blakeh01/capstone_pl/em_powerstage/Project Lab 4.kicad_pcb

## KiCad design em_powerstage/Project Lab 4.kicad_pcb (2024-09-30)

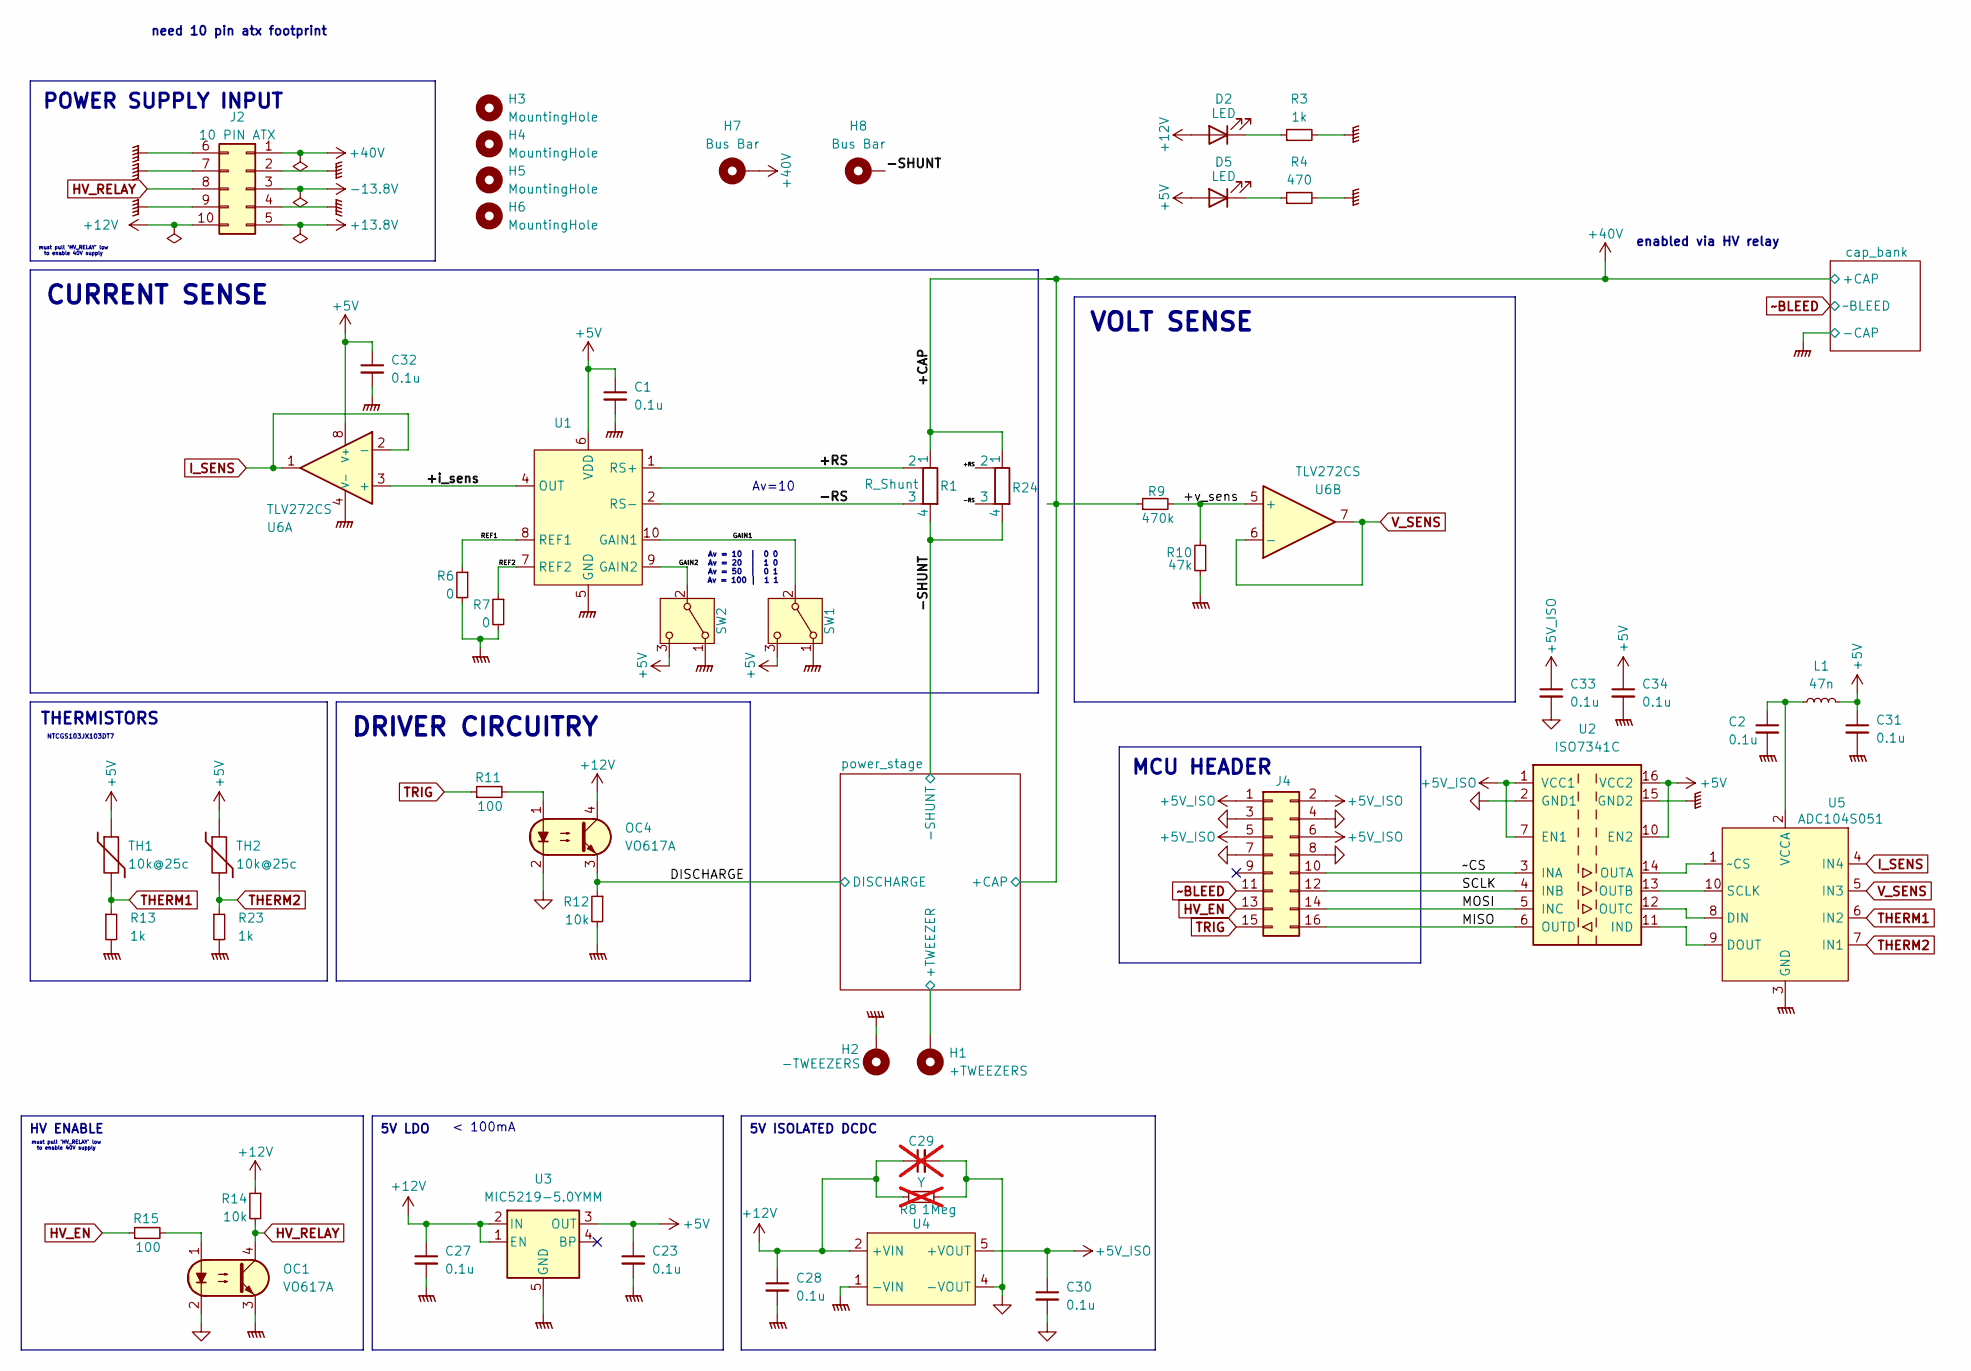
[picture p1: schematic Project Lab 4.kicad_sch]

Parts:
C1, C2, C23, C27, C28, C30, C31, C32, C33, C34: 0.1u; C_1206_3216Metric_Pad1.33x1.80mm_HandSolder
C29: Y; C_Disc_D8.0mm_W2.5mm_P5.00mm; not fitted
D2, D5: LED; LED_1206_3216Metric_Pad1.42x1.75mm_HandSolder
H1: +TWEEZERS; MountingHole_4.3mm_M4_Pad
H2: -TWEEZERS; MountingHole_4.3mm_M4_Pad
H3, H4, H5, H6: MountingHole; MountingHole_4mm
H7: Bus Bar; busbar_28mmX155mm
H8: Bus Bar; busbar_35mm_18mm
J2: 10 PIN ATX; Molex_Mini-Fit_Jr_5566-10A_2x05_P4.20mm_Vertical
J4: Conn_02x08_Odd_Even; PinHeader_2x08_P2.54mm_Vertical
L1: 47n; L_1206_3216Metric_Pad1.22x1.90mm_HandSolder
OC1, OC4: VO617A; DIP-4_W7.62mm_LongPads
R1: R_Shunt; CSS4J4026RL500F
R3, R13, R23: 1k; R_0805_2012Metric_Pad1.20x1.40mm_HandSolder
R4: 470; R_0805_2012Metric_Pad1.20x1.40mm_HandSolder
R6, R7: 0; R_0805_2012Metric_Pad1.20x1.40mm_HandSolder
R8: 1Meg; R_Axial_DIN0207_L6.3mm_D2.5mm_P15.24mm_Horizontal; not fitted
R9: 470k; R_0805_2012Metric_Pad1.20x1.40mm_HandSolder
R10: 47k; R_0805_2012Metric_Pad1.20x1.40mm_HandSolder
R11, R15: 100; R_0805_2012Metric_Pad1.20x1.40mm_HandSolder
R12, R14: 10k; R_0805_2012Metric_Pad1.20x1.40mm_HandSolder
R24: R_Shunt; CSM2F6918L050J21
SW1, SW2: SW_SPDT; SW_E-Switch_EG1271_SPDT
TH1, TH2: 10k@25c; R_0402_1005Metric_Pad0.72x0.64mm_HandSolder
U1: TDFN-10-SMD
U2: ISO7341C; SOIC-16W_7.5x10.3mm_P1.27mm
U3: MIC5219-5.0YMM; MSOP-8_3x3mm_P0.65mm
U4: 1769405241
U5: ADC104S051; MSOP-10-1EP_3x3mm_P0.5mm_EP1.73x1.98mm
U6: TLV272CS; SO-8_3.9x4.9mm_P1.27mm

Connections:
+5V: C1.1, C23.1, C31.1, C32.1, C34.1, D5.2 (A), L1.2, SW1.3 (C), SW2.3 (C), TH1.1, TH2.1, U1.6 (VDD), U2.10 (EN2), U2.16 (VCC2), U3.3 (OUT), U6.8 (V+)
+5V_ISO: C30.1, C33.1, J4.1, J4.2, J4.5, J4.6, U2.1 (VCC1), U2.7 (EN1), U4.5 (+VOUT)
+12V: C27.1, C28.1, C29.1, D2.2 (A), J2.10, OC4.4, R8.1, R14.1, U3.1 (EN), U3.2 (IN), U4.2 (+VIN); also elsewhere on the board
+13.8V: J2.5
+40V: H7.1, J2.1, R1.1, R9.1, R24.1; also elsewhere on the board
-13.8V: J2.3
/+RS: R1.2, R24.2, U1.1 (RS+)
/+i_sens: U1.4 (OUT), U6.3 (+)
/+v_sens: R9.2, R10.2, U6.5 (+)
/-RS: R1.3, R24.3, U1.2 (RS-)
/-SHUNT: H8.1, R1.4, R24.4; also elsewhere on the board
/DISCHARGE: OC4.3, R12.1; also elsewhere on the board
/GAIN1: SW1.2 (B), U1.10 (GAIN1)
/GAIN2: SW2.2 (B), U1.9 (GAIN2)
/MISO: J4.16, U2.6 (OUTD)
/MOSI: J4.14, U2.5 (INC)
/REF1: R6.1, U1.8 (REF1)
/REF2: R7.1, U1.7 (REF2)
/SCLK: J4.12, U2.4 (INB)
/power_stage/+TWEEZER: H1.1; also elsewhere on the board
/~CS: J4.10, U2.3 (INA)
GND: C29.2, C30.2, C33.2, J4.3, J4.4, J4.7, J4.8, OC1.2, OC4.2, R8.2, U2.2 (GND1), U2.8 (GND1), U4.4 (-VOUT); also elsewhere on the board
GNDPWR: C1.2, C2.2, C23.2, C27.2, C28.2, C31.2, C32.2, C34.2, H2.1, J2.2, J2.4, J2.6, J2.7, J2.9, OC1.3, R3.2, R4.2, R6.2, R7.2, R10.1, R12.2, R13.2, R23.2, SW1.1 (A), SW2.1 (A), U1.5 (GND), U2.9 (GND2), U2.15 (GND2), U3.5 (GND), U3.6 (GND), U3.7 (GND), U3.8 (GND), U4.1 (-VIN), U5.3 (GND), U6.4 (V-); also elsewhere on the board
HV_EN: J4.13, R15.1
HV_RELAY: J2.8, OC1.4, R14.2
I_SENS: U5.4 (IN4), U6.1, U6.2 (-)
unnamed: D2.1 (K), R3.1
unnamed: D5.1 (K), R4.1
unnamed: OC1.1, R15.2
unnamed: OC4.1, R11.2
unnamed: U2.11 (IND), U5.9 (DOUT)
unnamed: U2.14 (OUTA), U5.1 (~CS)
unnamed: U2.13 (OUTB), U5.10 (SCLK)
unnamed: U2.12 (OUTC), U5.8 (DIN)
unnamed: C2.1, L1.1, U5.2 (VCCA)
THERM1: R13.1, TH1.2, U5.6 (IN2)
THERM2: R23.1, TH2.2, U5.7 (IN1)
TRIG: J4.15, R11.1
V_SENS: U5.5 (IN3), U6.6 (-), U6.7
~BLEED: J4.11; also elsewhere on the board

Notes on the sheet:
POWER SUPPLY INPUT
5V ISOLATED DCDC
MCU HEADER
HV ENABLE
DRIVER CIRCUITRY
5V LDO
CURRENT SENSE
VOLT SENSE
THERMISTORS
must pull 'HV_RELAY' low to enable 40V supply
enabled via HV relay
NTCGS103JX103DT7
need 10 pin atx footprint
< 100mA
Av = 10 | 0 0 Av = 20 | 1 0 Av = 50 | 0 1 Av = 100 | 1 1
Av=10

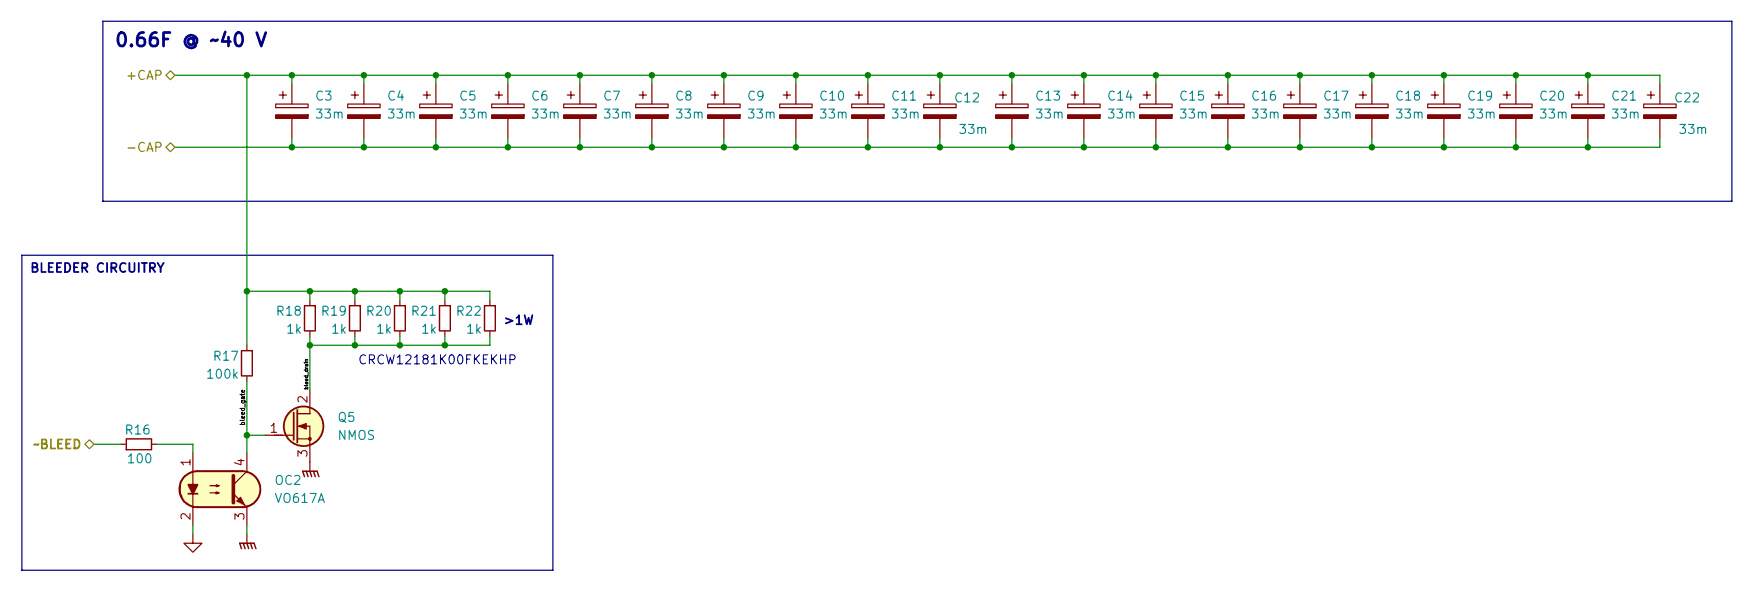
[picture p2: schematic cap_bank.kicad_sch]

Parts:
C3, C4, C5, C6, C7, C8, C9, C10, C11, C12, C13, C14, C15, C16, C17, C18, C19, C20, C21, C22: 33m; CAPPRD1000W190D3550H8200
OC2: VO617A; DIP-4_W7.62mm_LongPads
Q5: NMOS; SOT-23-3
R16: 100; R_0805_2012Metric_Pad1.20x1.40mm_HandSolder
R17: 100k; R_0805_2012Metric_Pad1.20x1.40mm_HandSolder
R18, R19, R20, R21, R22: 1k; R_1218_3246Metric_Pad1.22x4.75mm_HandSolder

Connections:
+40V: C3.1, C4.1, C5.1, C6.1, C7.1, C8.1, C9.1, C10.1, C11.1, C12.1, C13.1, C14.1, C15.1, C16.1, C17.1, C18.1, C19.1, C20.1, C21.1, C22.1, R17.1, R18.1, R19.1, R20.1, R21.1, R22.1; also elsewhere on the board
/cap_bank/bleed_drain: Q5.2 (D), R18.2, R19.2, R20.2, R21.2, R22.2
/cap_bank/bleed_gate: OC2.4, Q5.1 (G), R17.2
GND: OC2.2; also elsewhere on the board
GNDPWR: C3.2, C4.2, C5.2, C6.2, C7.2, C8.2, C9.2, C10.2, C11.2, C12.2, C13.2, C14.2, C15.2, C16.2, C17.2, C18.2, C19.2, C20.2, C21.2, C22.2, OC2.3, Q5.3 (S); also elsewhere on the board
unnamed: OC2.1, R16.2
~BLEED: R16.1; also elsewhere on the board

Notes on the sheet:
BLEEDER CIRCUITRY
0.66F @ ~40 V
CRCW12181K00FKEKHP
>1W

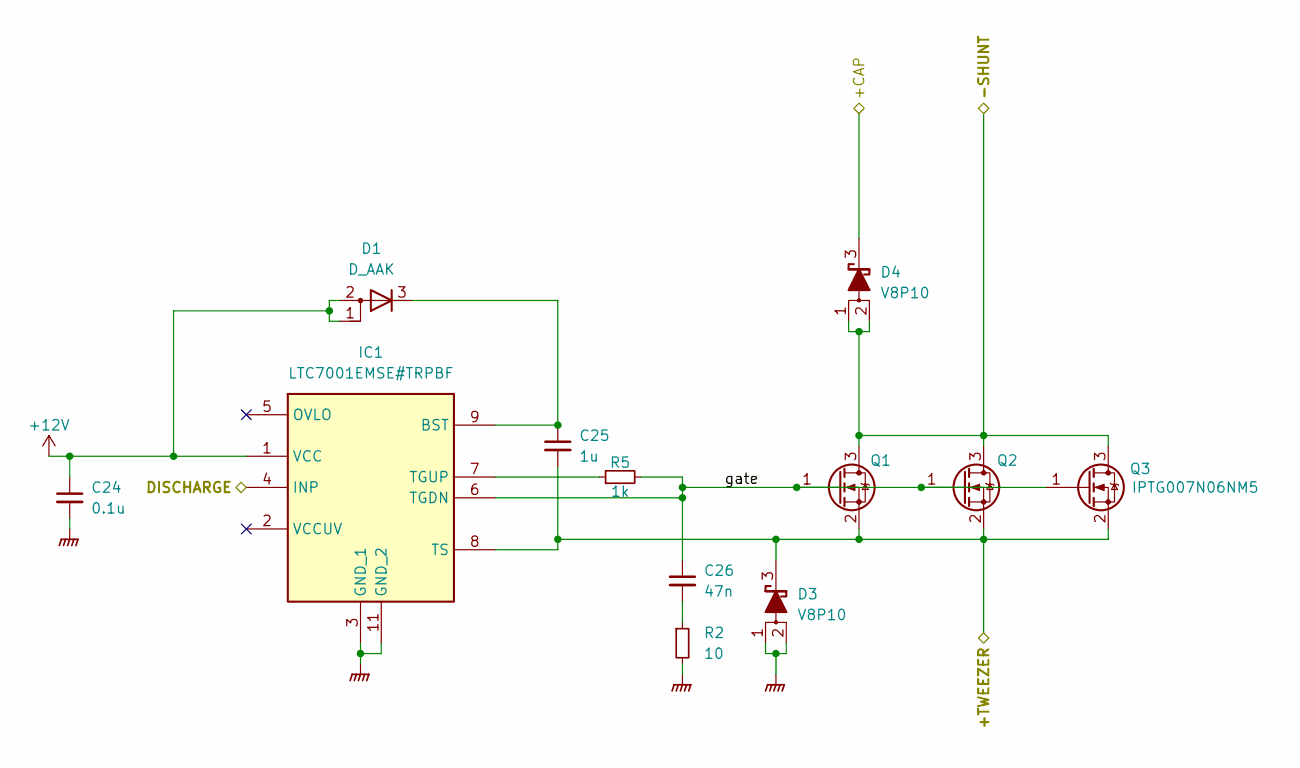
[picture p3: schematic power_stage.kicad_sch]

Parts:
C24: 0.1u; C_1206_3216Metric_Pad1.33x1.80mm_HandSolder
C25: 1u; C_1206_3216Metric_Pad1.33x1.80mm_HandSolder
C26: 47n; C_0805_2012Metric_Pad1.18x1.45mm_HandSolder
D1: D_AAK; SOT-23-3
D3, D4: V8P10; TO-277A
IC1: LTC7001EMSE#TRPBF; SOP50P490X110-11N; Mouser Part Number 584-7001EMSETRPBF
Q1, Q2, Q3: IPTG007N06NM5; HSOG_8-3
R2: 10; R_0805_2012Metric_Pad1.20x1.40mm_HandSolder
R5: 1k; R_0805_2012Metric_Pad1.20x1.40mm_HandSolder

Connections:
+12V: C24.1, D1.1 (A), D1.2 (A), IC1.1 (VCC); also elsewhere on the board
+40V: D4.3 (K); also elsewhere on the board
/-SHUNT: D4.1 (A), D4.2 (A), Q1.3 (D), Q2.3 (D), Q3.3 (D); also elsewhere on the board
/DISCHARGE: IC1.4 (INP); also elsewhere on the board
/power_stage/+TWEEZER: C25.2, D3.3 (K), IC1.8 (TS), Q1.2 (S), Q2.2 (S), Q3.2 (S); also elsewhere on the board
/power_stage/gate: C26.1, IC1.6 (TGDN), Q1.1 (G), Q2.1 (G), Q3.1 (G), R5.2
GNDPWR: C24.2, D3.1 (A), D3.2 (A), IC1.3 (GND_1), IC1.11 (GND_2), R2.2; also elsewhere on the board
unnamed: C26.2, R2.1
unnamed: C25.1, D1.3 (K), IC1.9 (BST)
unnamed: IC1.7 (TGUP), R5.1

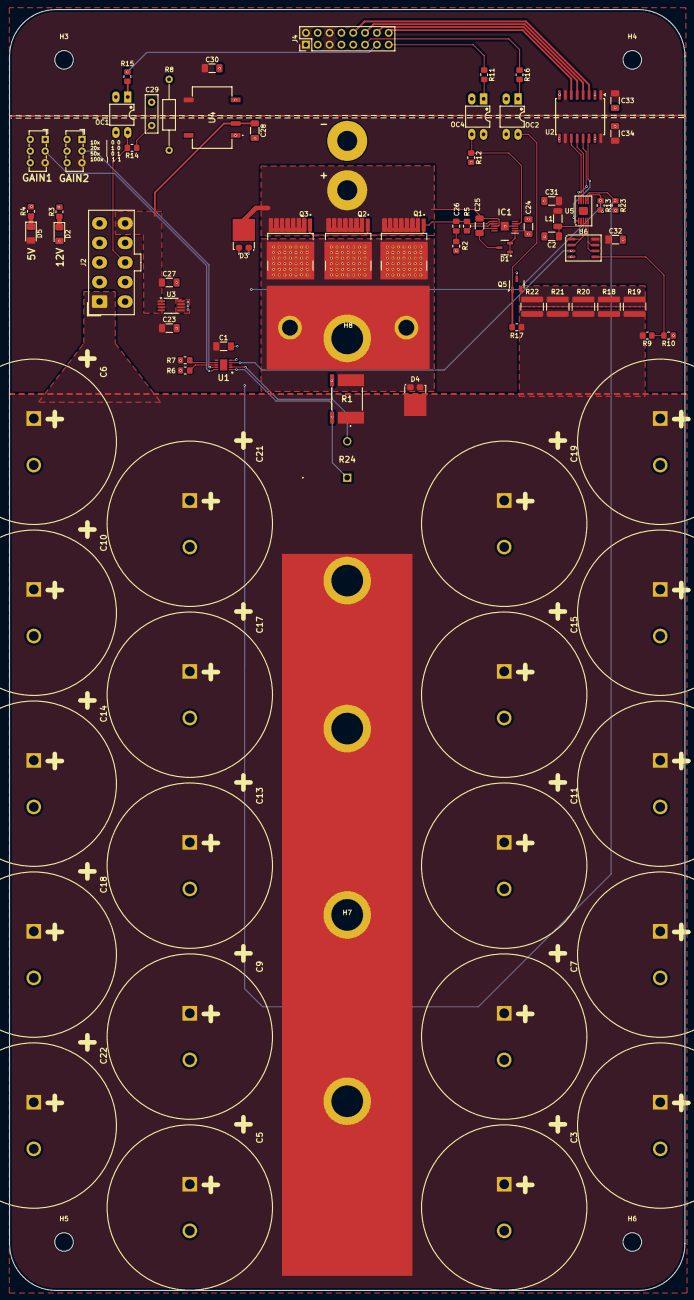
[picture p4: board Project Lab 4.kicad_pcb from above]

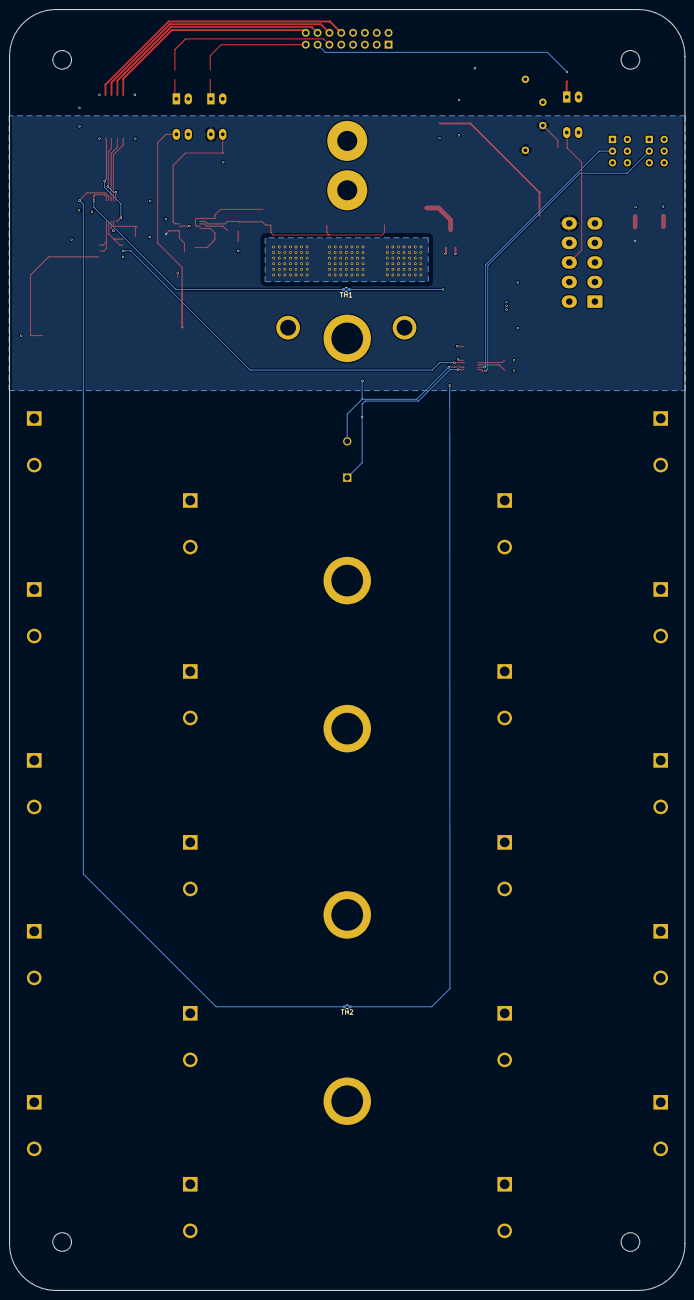
[picture p5: board Project Lab 4.kicad_pcb from below]

Board: 4 copper layers, 145.0 x 275.0 mm, 92 parts (2 on the bottom side), 45 nets.
